FPGA-Computer/Soapbox-Racer/README.md

Soapbox-Racer
=============

This is the repository for the FPGA Computer "Soapbox Racer" PCB.

Schematic tool: Eagle CAD 6.5.0
3D modelling: Sketchup 14.1 2014

Licensing:
Due to the different ownership of the contributed files, the licensing
is complicated.  Please read the license.txt and additional copyright
notices in the individual files.

Schematic is distributed with Creative Commons 4.0 Attribution-NonCommercial
Layout artwork: (C) Copyrights 2014 all reserved by K. C. Lee
3D modelling: Creative Commons 4.0 Attribution-NonCommercial-NoDerivs International

Firmware/FPGA core: mixed based on the copyrights of the original
owners. Please read the individual files.  I'll try to make my code compatible to 
the contributed source code whenever possible.

Creative Commons 4.0 Attribution-NonCommercial:
See http://creativecommons.org/licenses/by-nc/4.0/

Creative Commons 4.0 Attribution-NonCommercial-NoDerivatives International
See http://creativecommons.org/licenses/by-nc-nd/4.0/
