FPGA-Computer/Soapbox-Racer/Hardware/Rev 0/Defect list/Defect 1.pdf

[Edit project log - Delete project log]

This is a project log entry for FPGA Computer/Eval board

# Defect list

I guess I should start maintaining a defect list:

Library: | con-usb-2.lbr by Erik Christiansson; | also | con-usb-3.lbr by same
author

Level: Serious, require localized copper change

Problem has not been resolved in con-usb-3.lbr at Cadsoft ftp.

Acon UAR80-4* datasheet clearly shown pin 1 location (USB Bus Power), but instead it is connected to ground. Seems like all the pin numbering is wrong, so all pins are affected.

Foorprint:

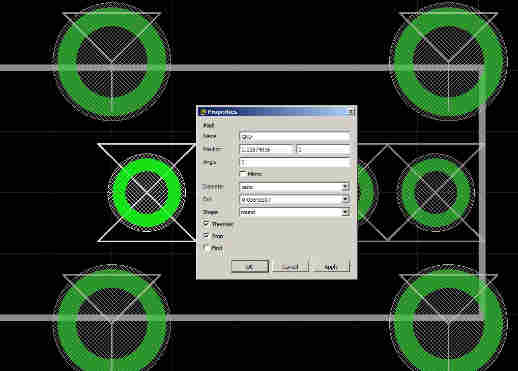
[picture p1: figure]

USB 2.0 standard:

Projects | Hackers | Blog | Search | Add a Project
More | Feed

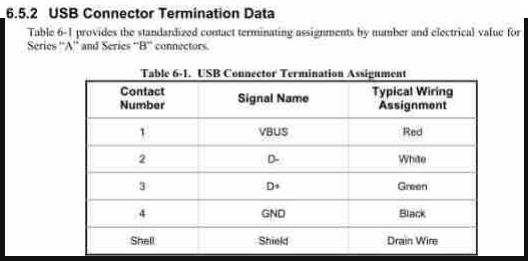
[picture p2: figure]
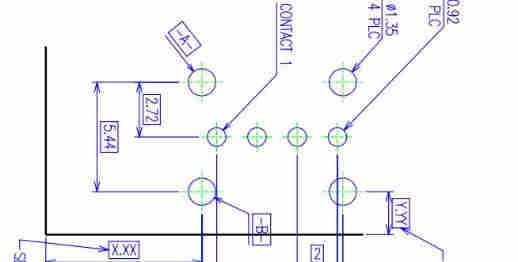
[picture p3: figure]
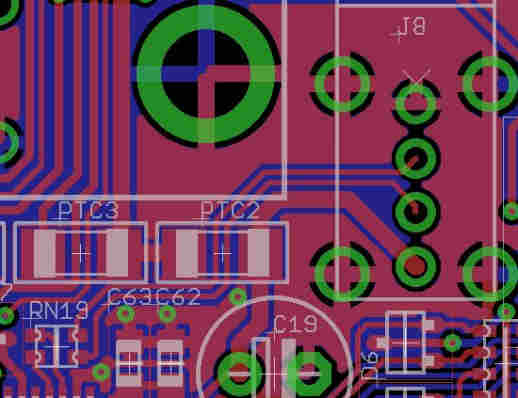
[picture p4: figure]

DISCUSSIONS

Add your comment

ACON Connector datasheet

Short term fix:

From a mechanical strength/appearance point of view, I should keep the
connector as is, | USB signals | are best reversed | at RN19 to preserve the
routing. Power/ground can be reverse | by cutting trace and thermals next to
connector pin and | jumper by magnetic | wire.
