FPGA-Computer/Soapbox-Racer/Hardware/Rev 0/FPGA Computer Rev15 Rel 0 (no fills).pdf

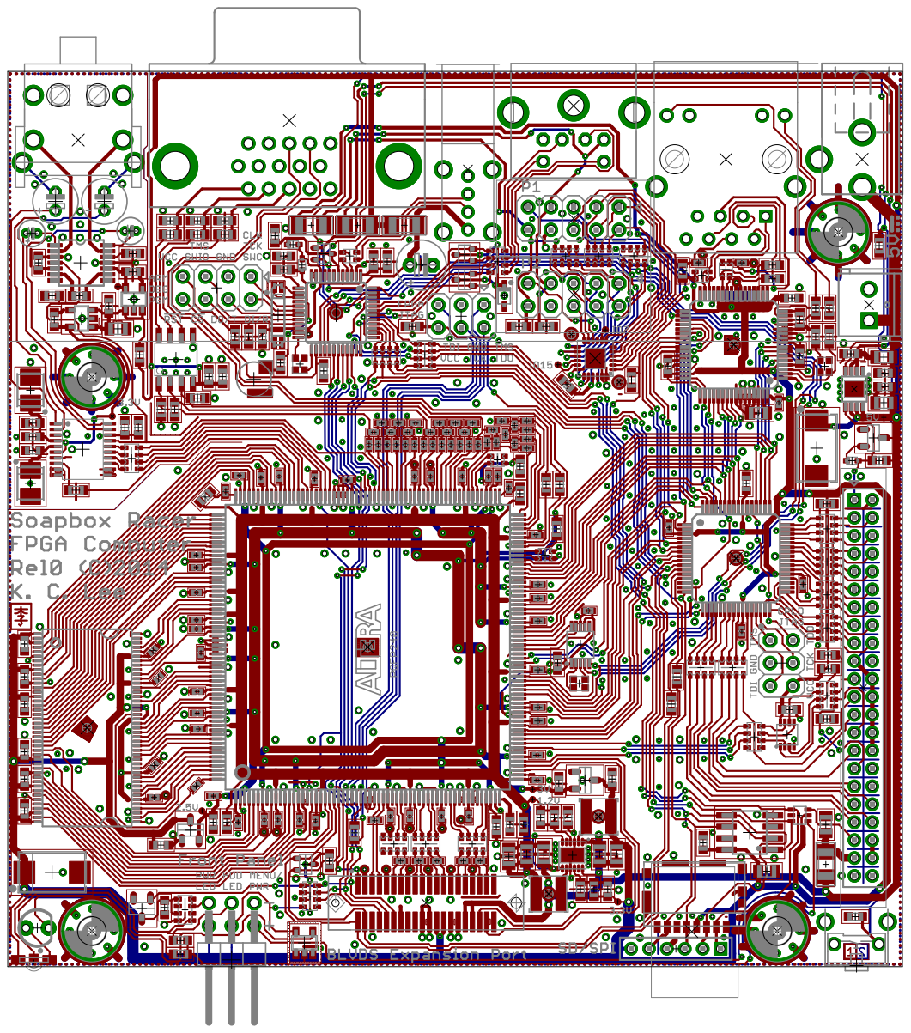
[picture p5: page 1]
