FPGA-Computer/Soapbox-Racer/Hardware/Rev 0/FPGA Computer Rev15 Rel 0 (plane fills).pdf

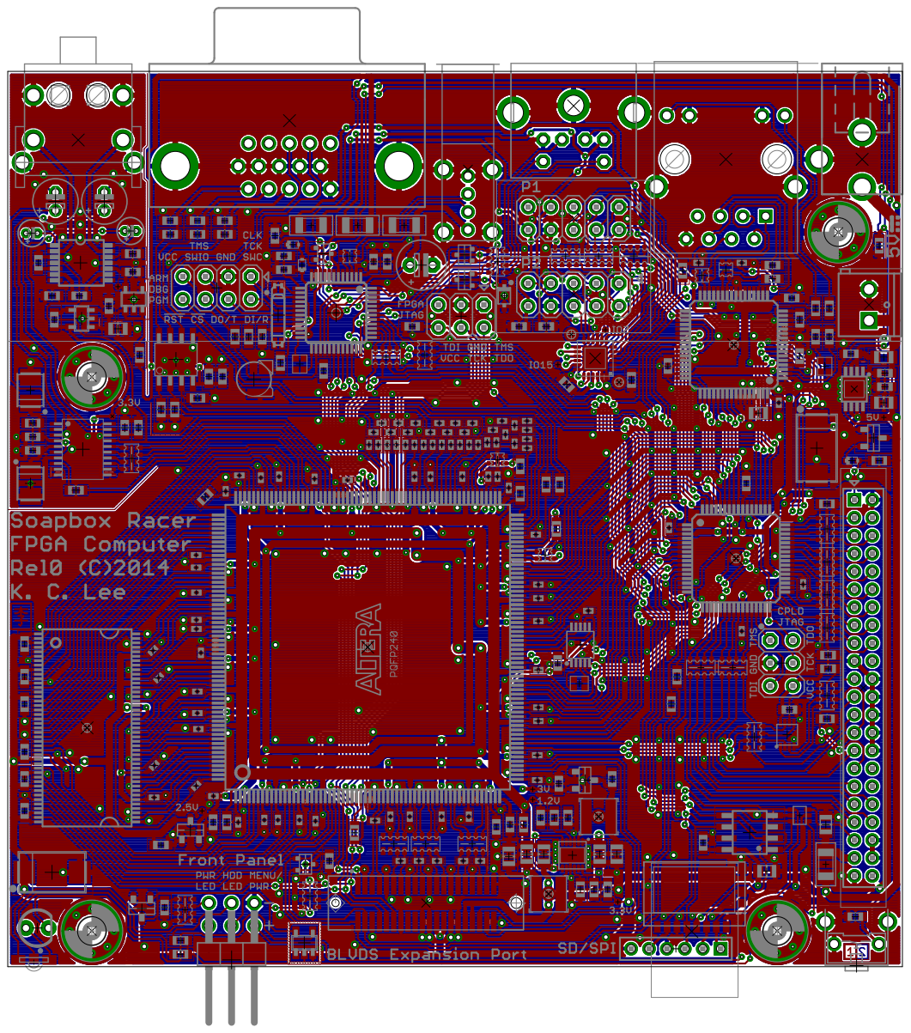
[picture p6: page 1]
