FPGA-Computer/Soapbox-Racer/Hardware/Rev 0/FPGA Computer Rev15 Rel 0.pdf

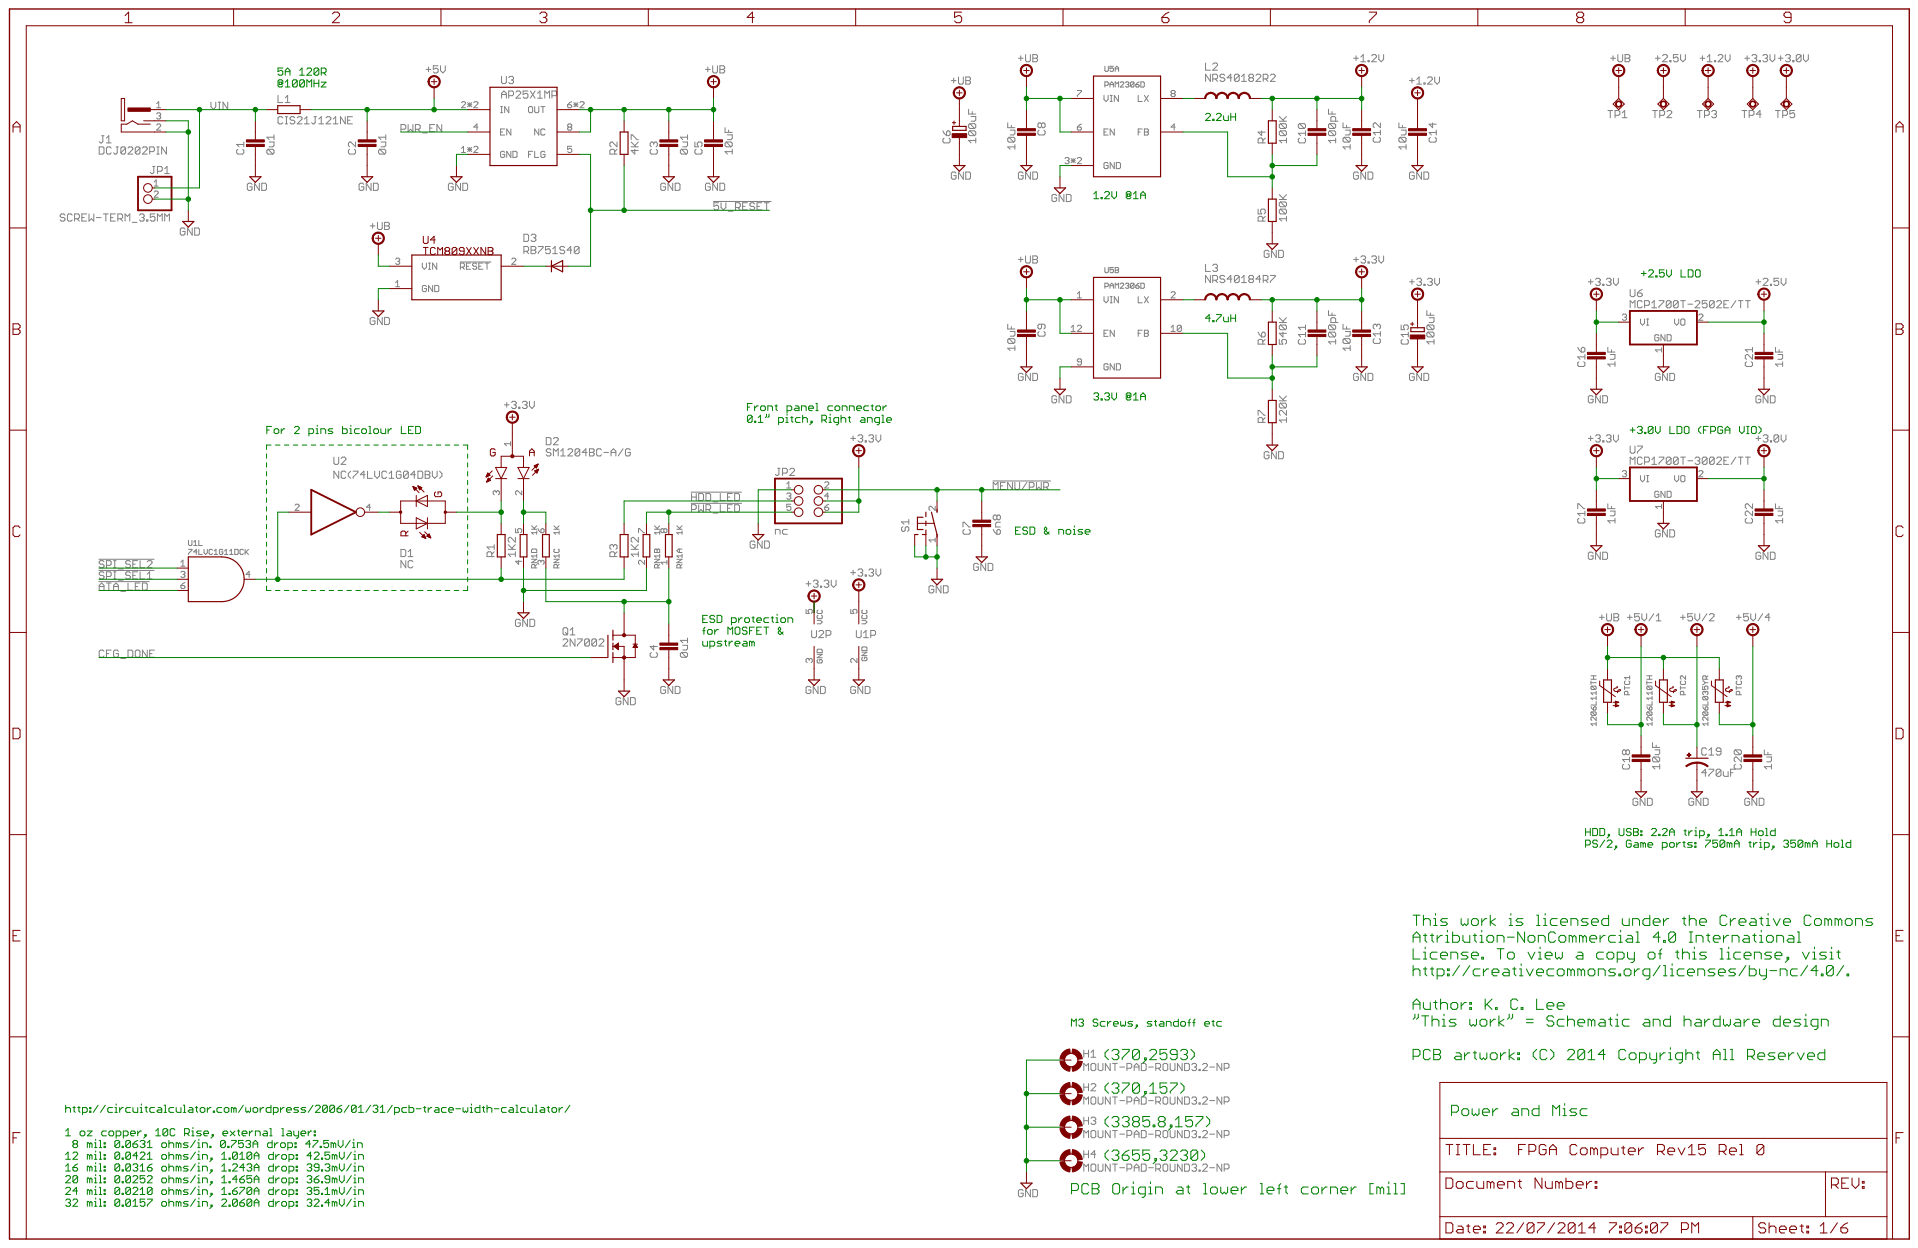
[picture p7: page 1]

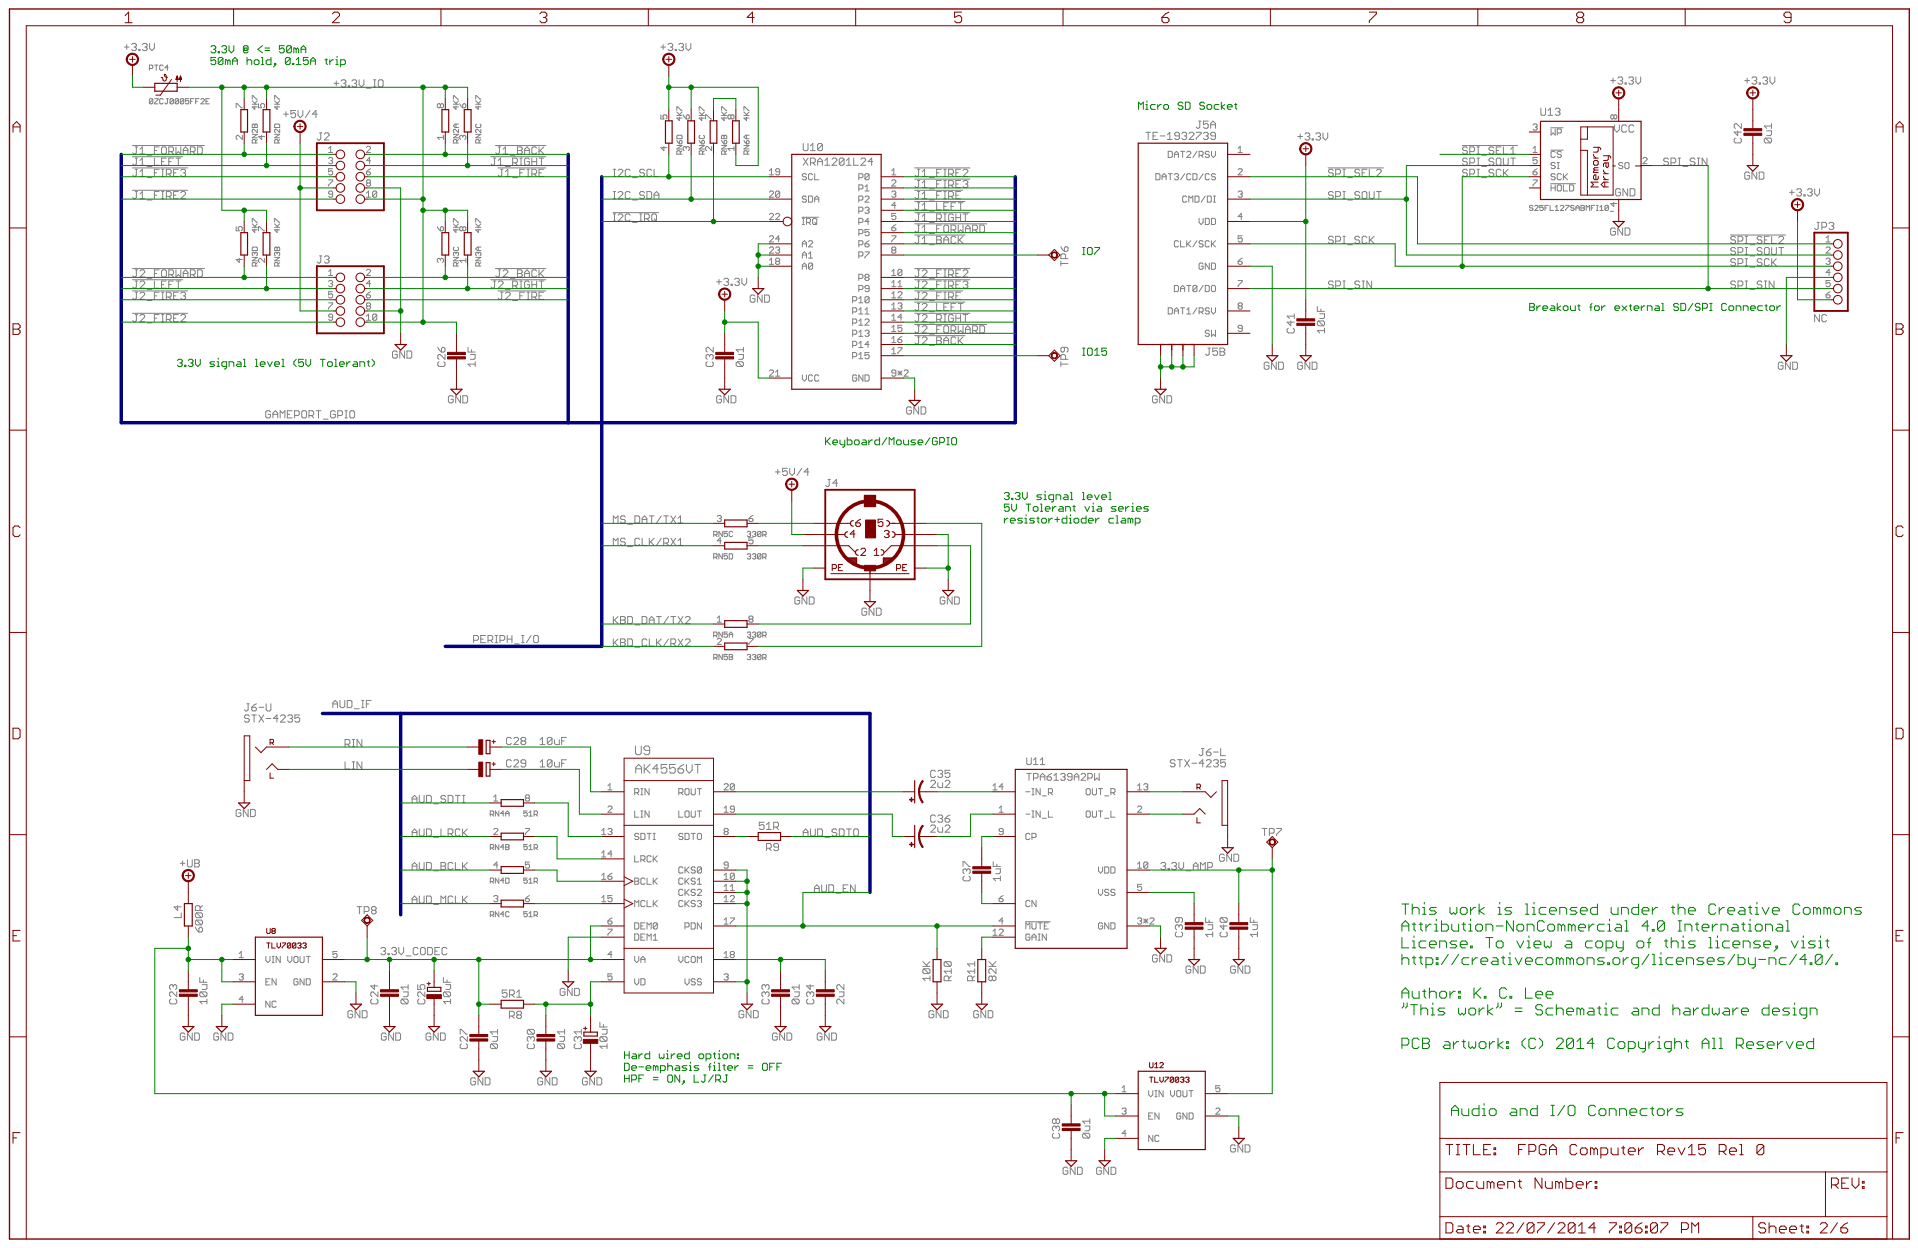
[picture p8: page 2]

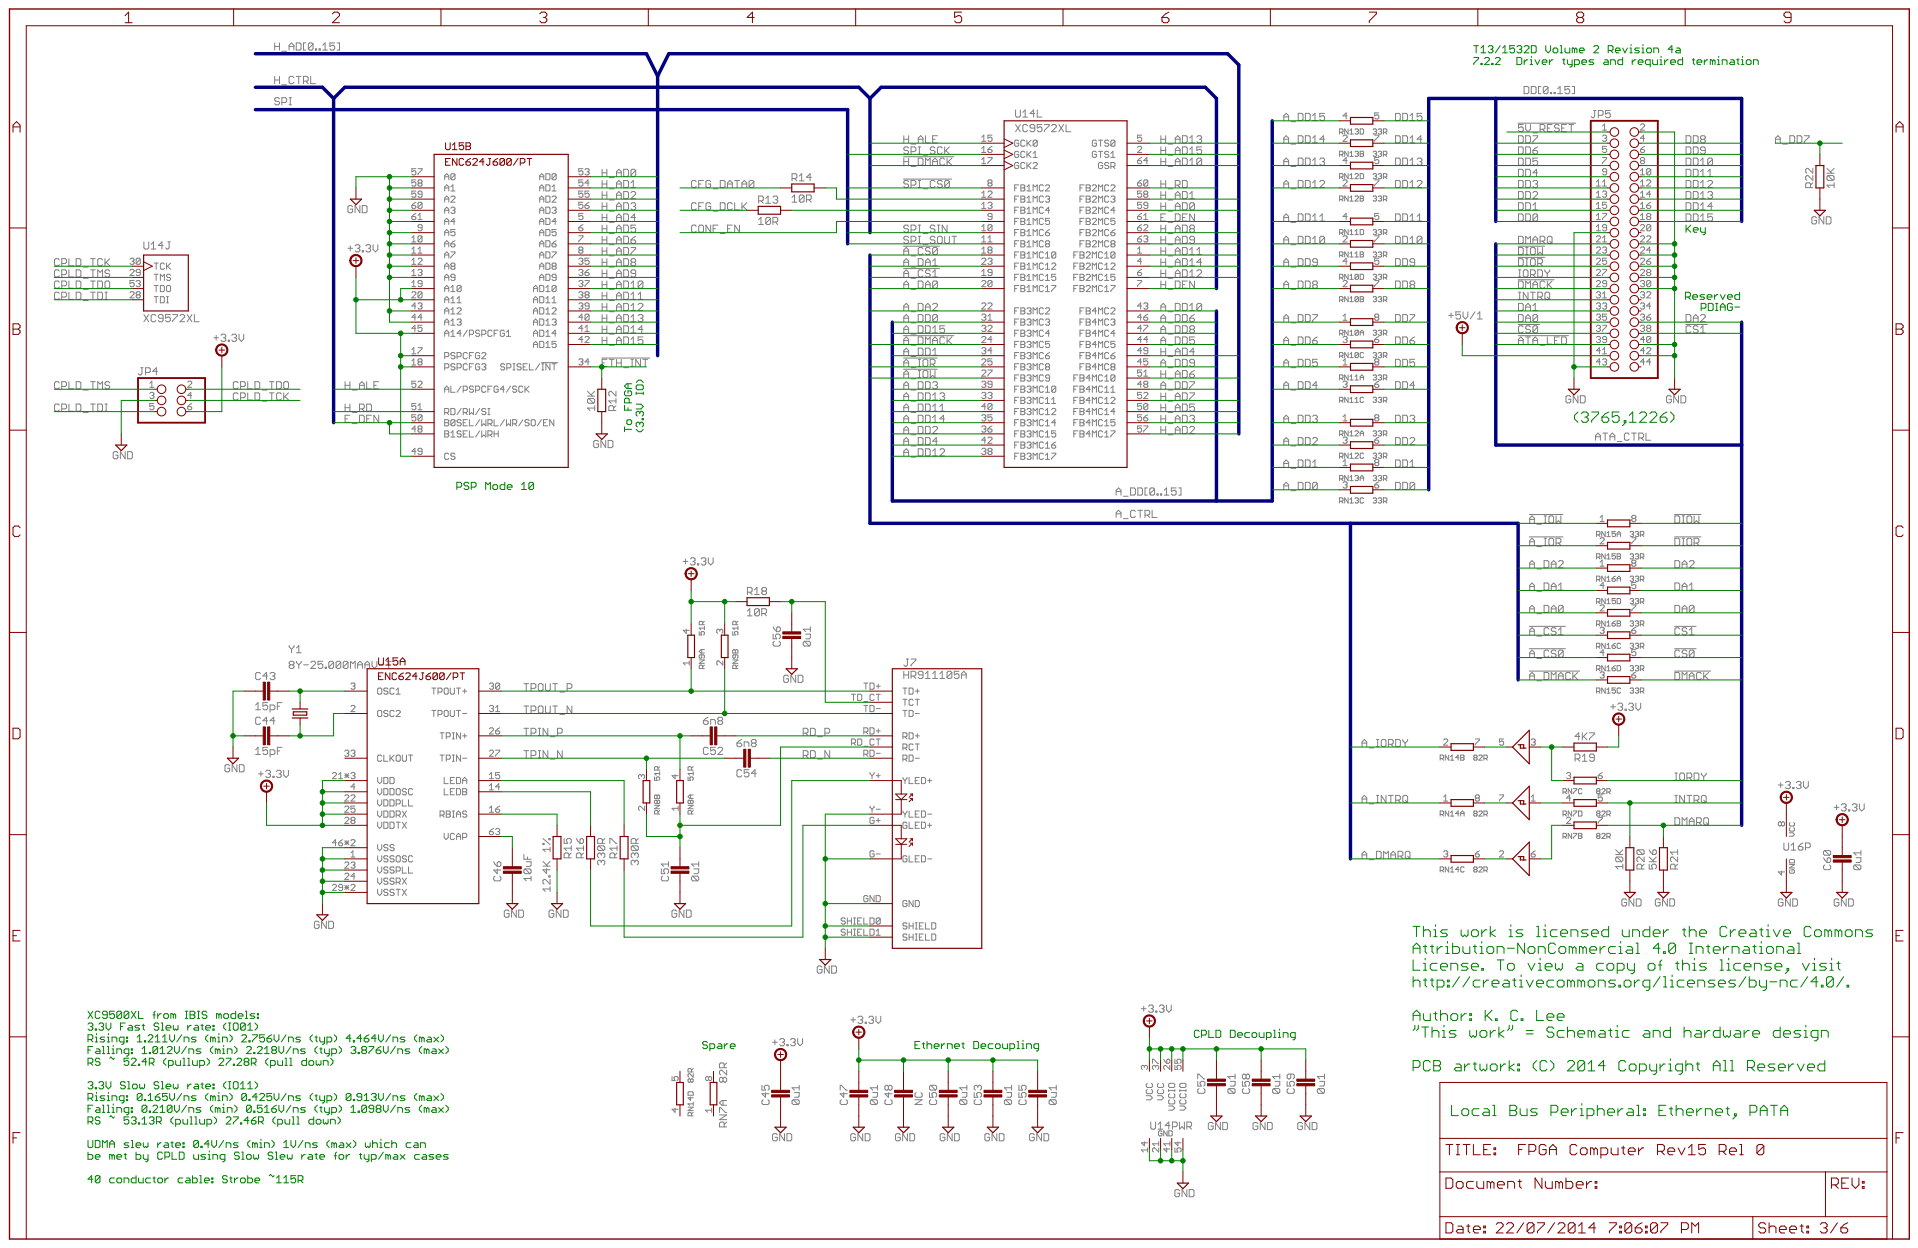
[picture p9: page 3]

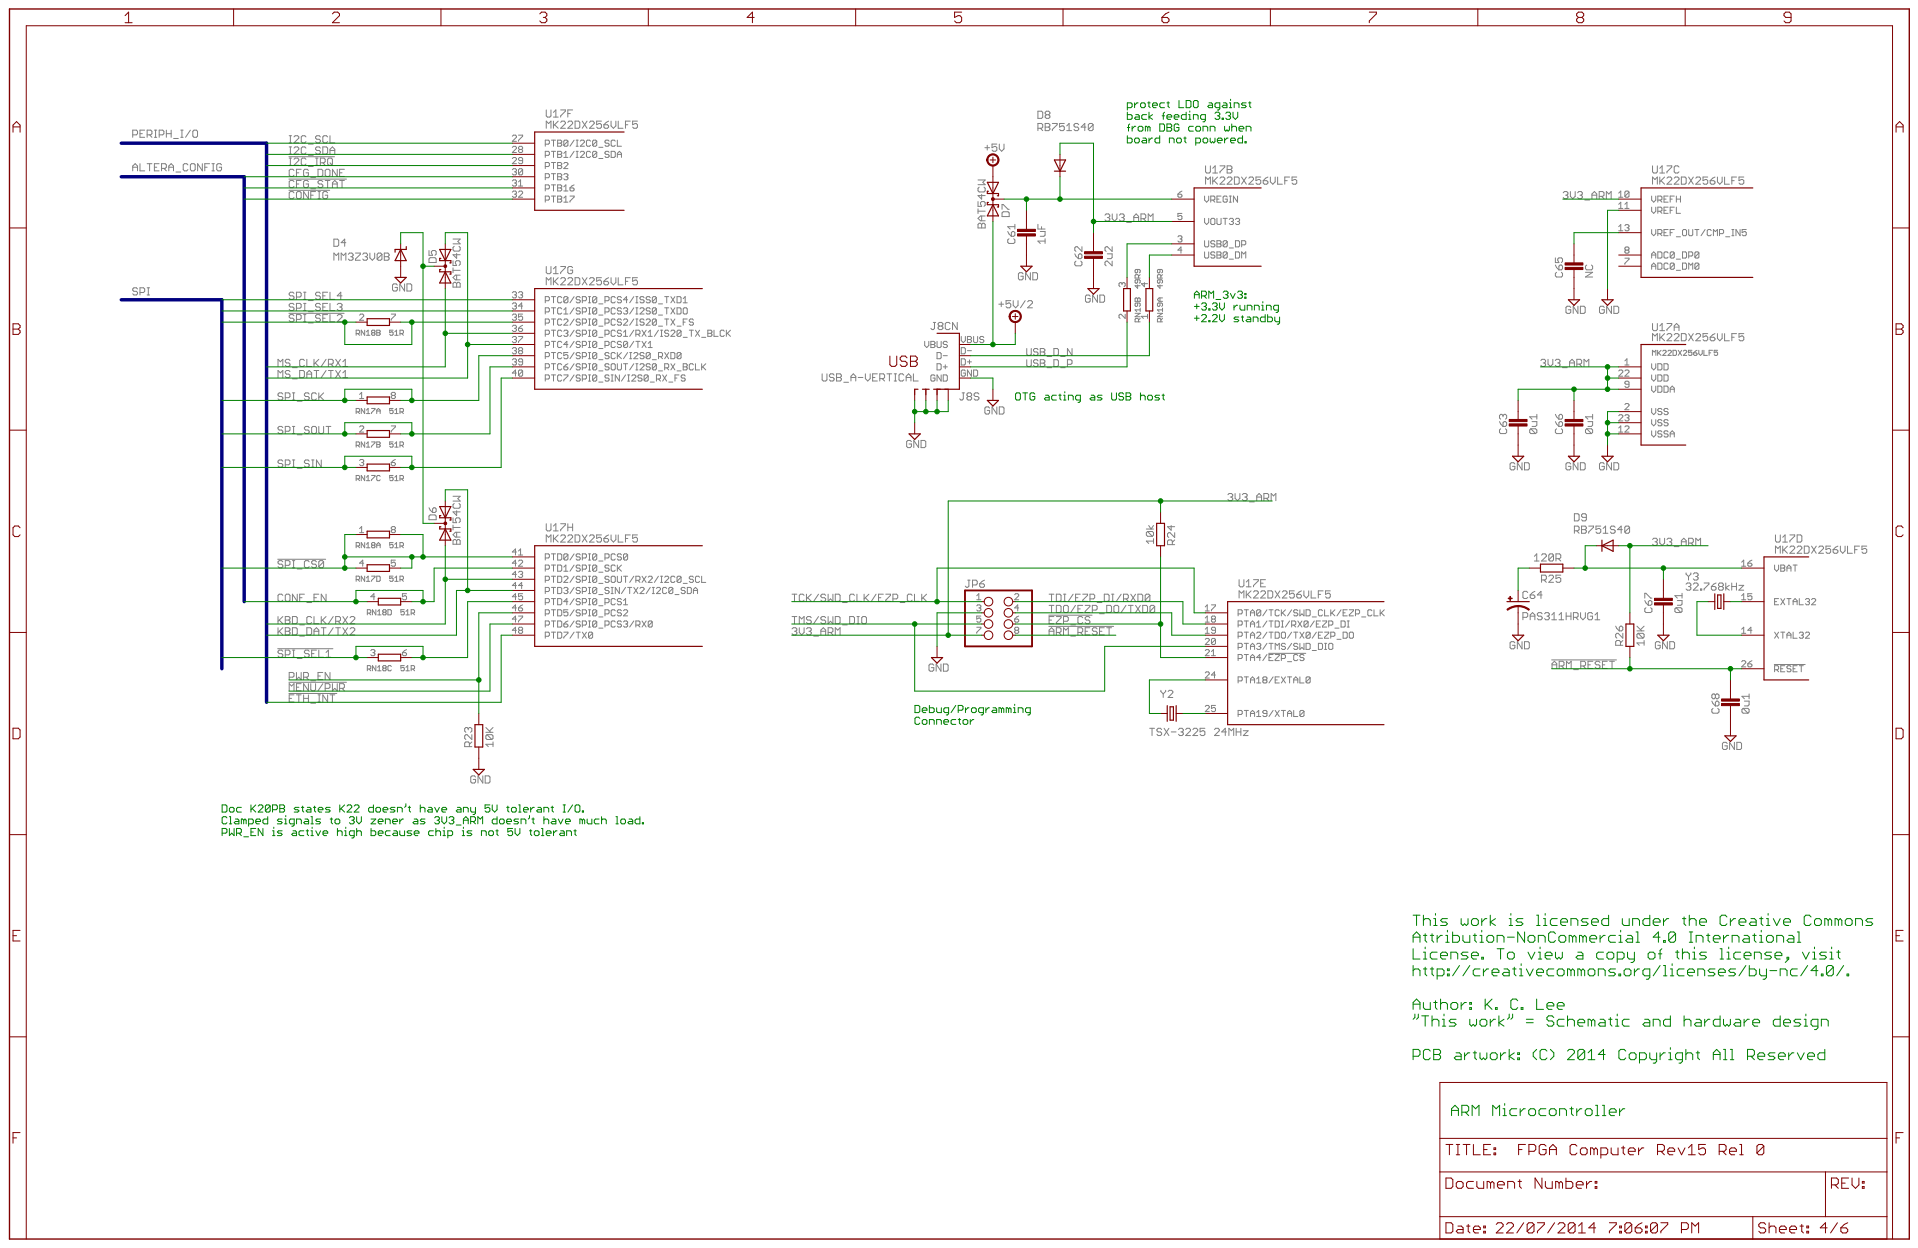
[picture p10: page 4]

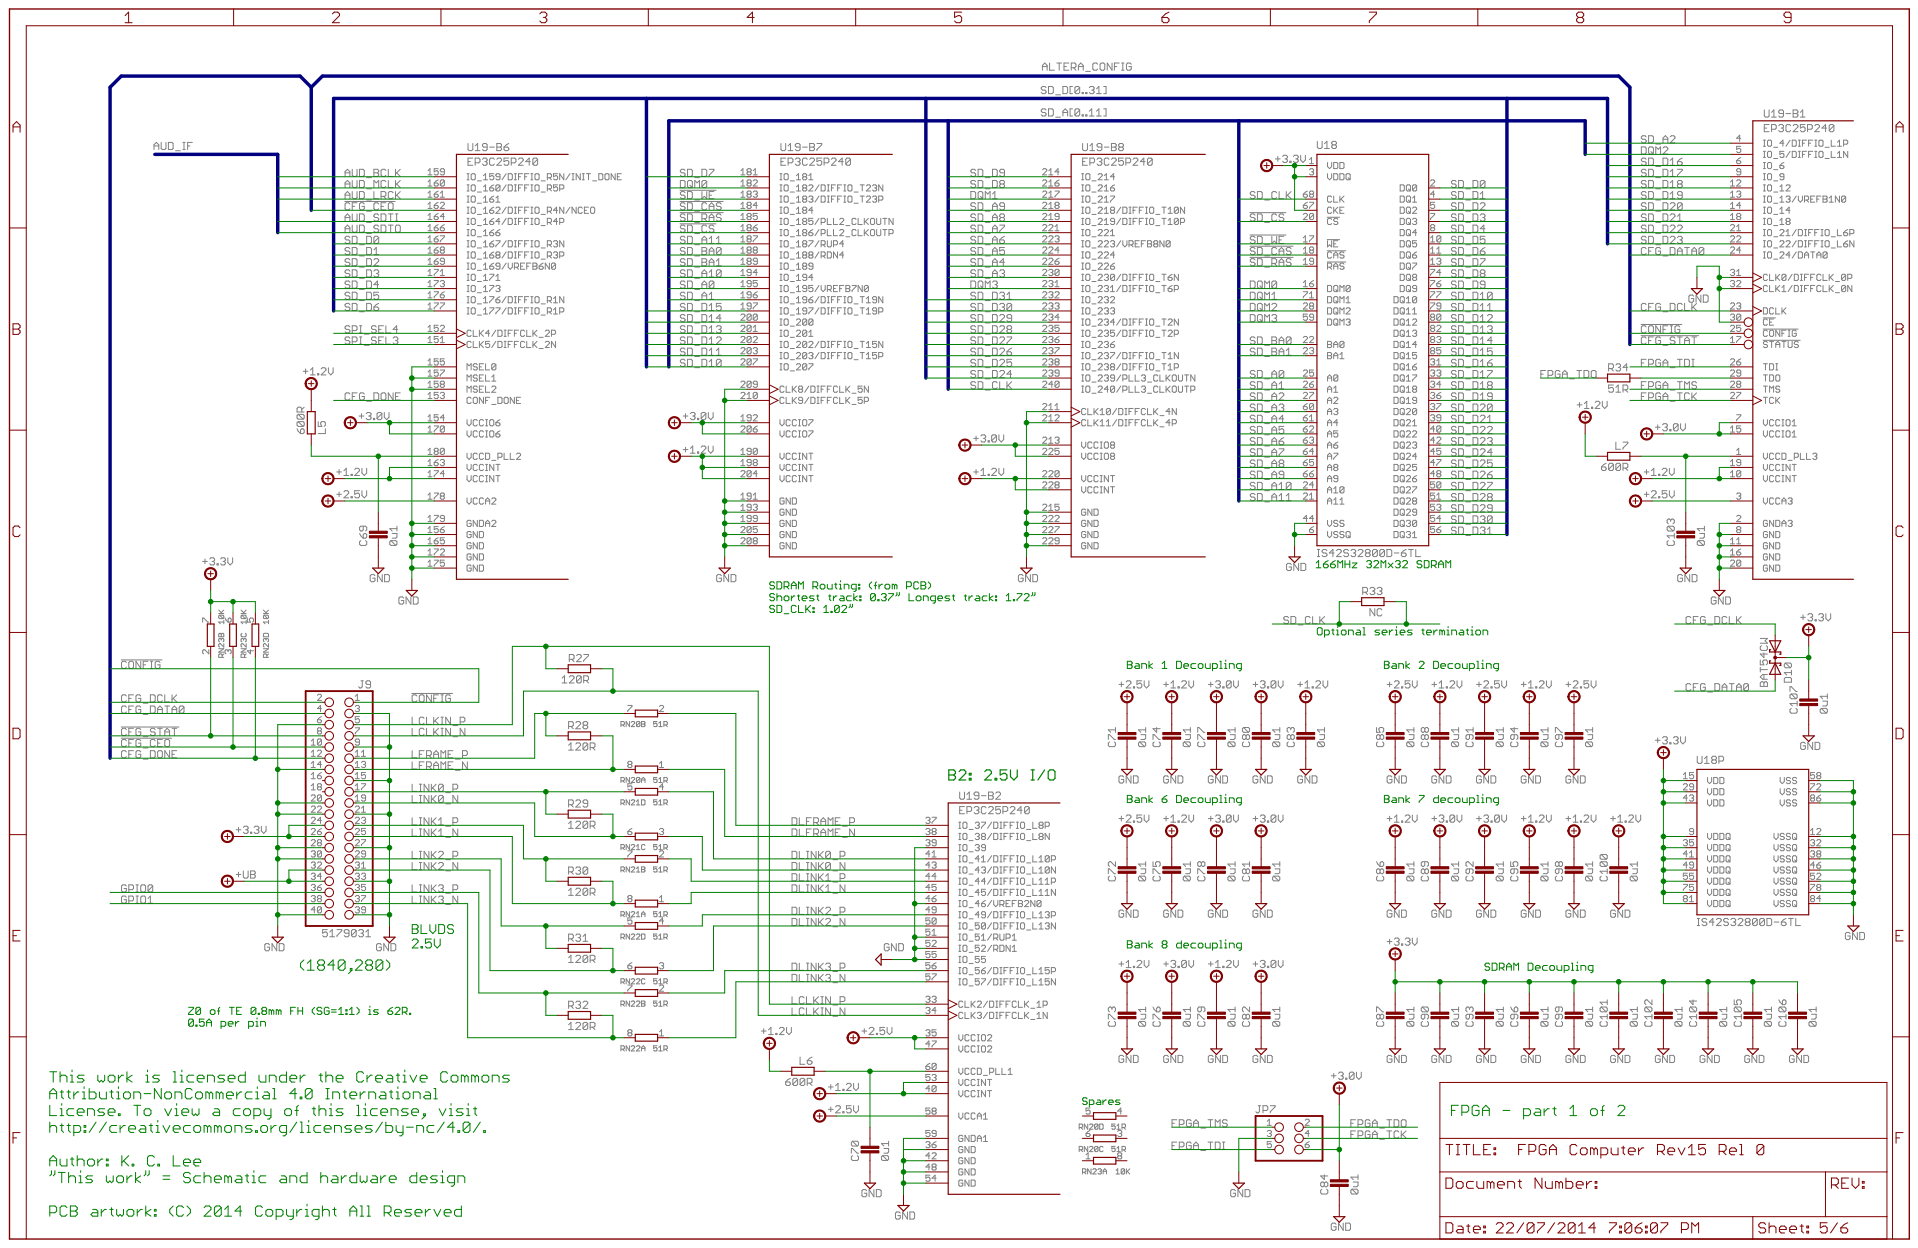
[picture p11: page 5]

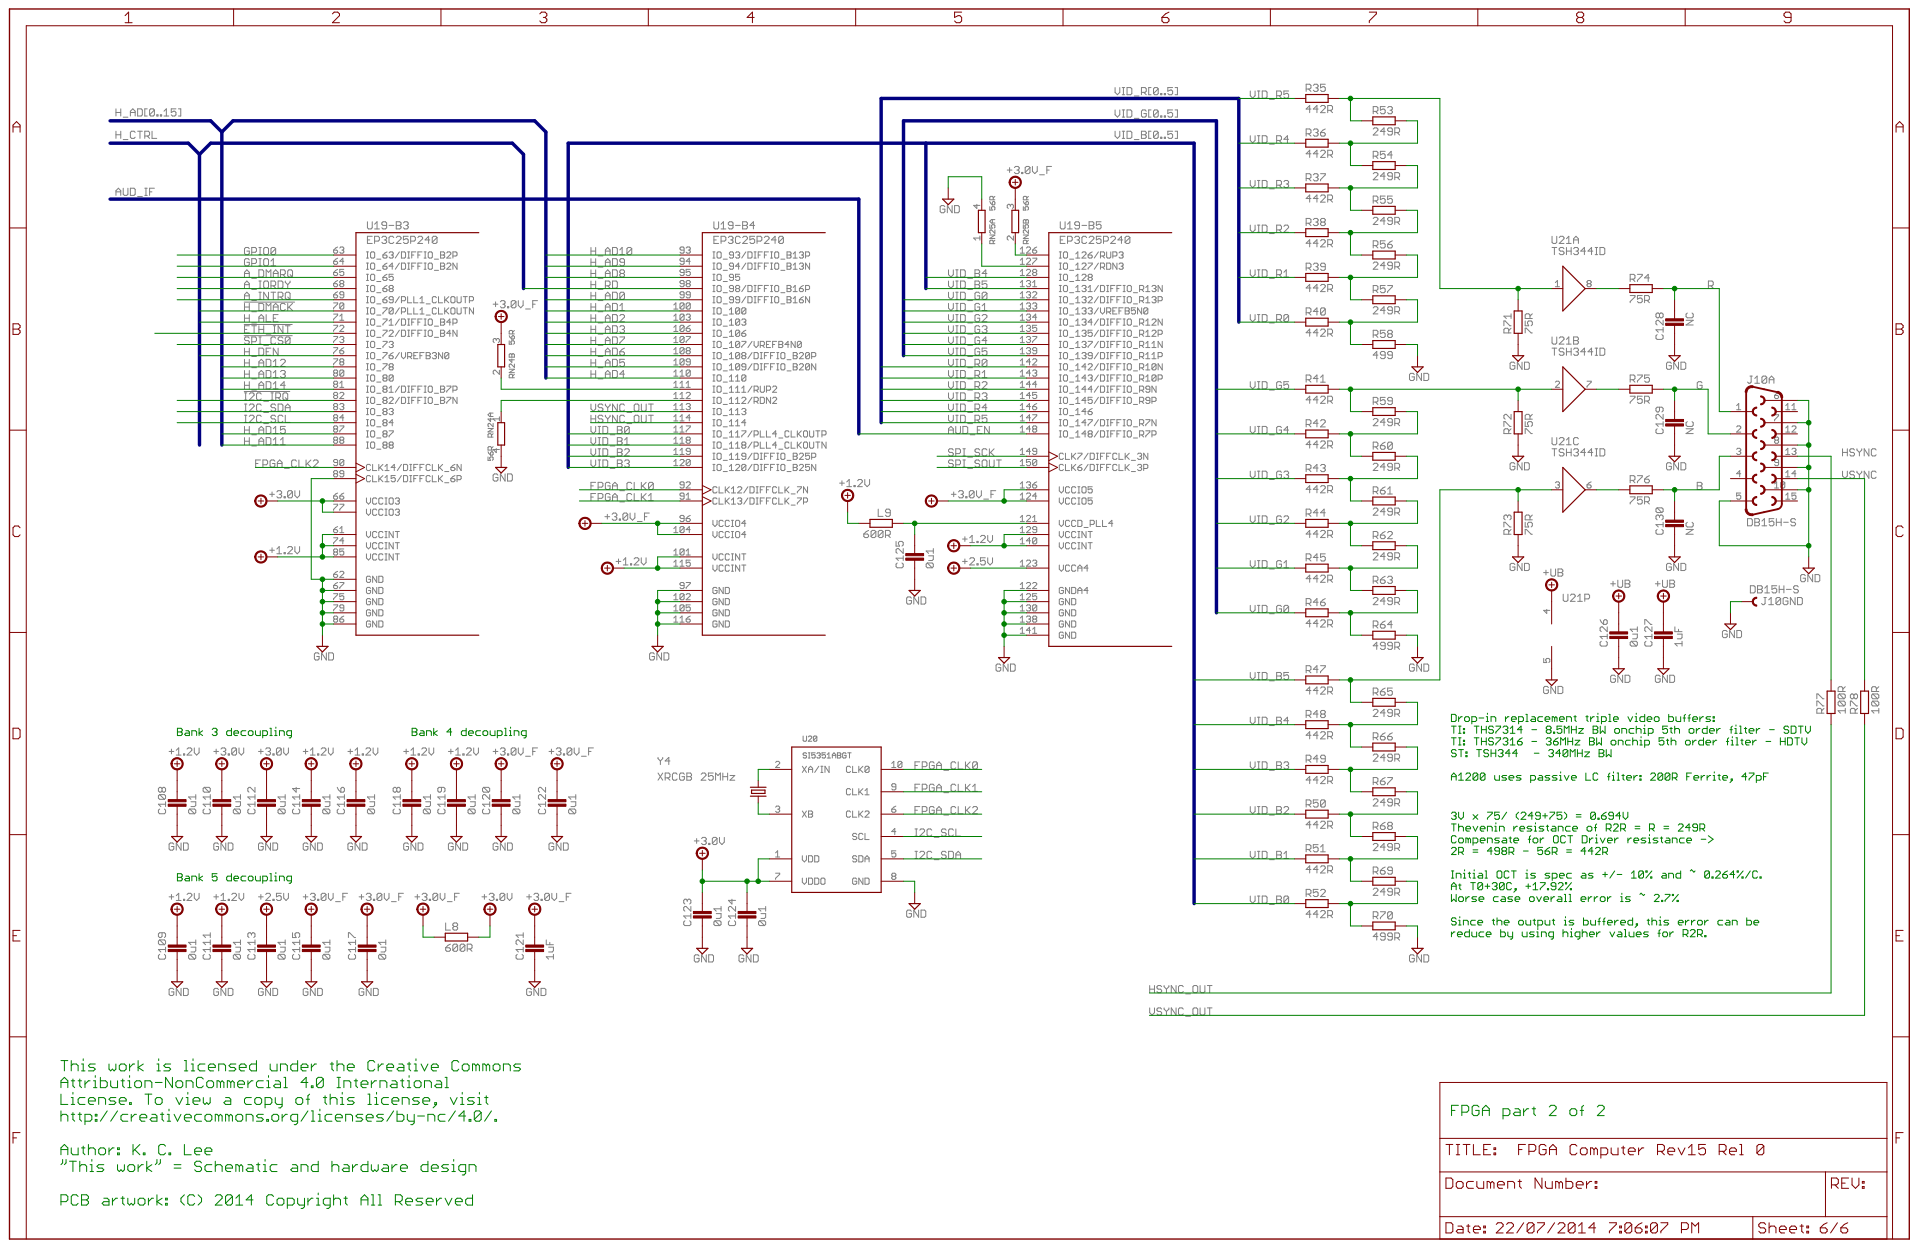
[picture p12: page 6]
