FPGA-Computer/Soapbox-Racer/Firmware/FatFS Demo/fattime.h

#ifndef FATTIME_H_
#define FATTIME_H_

#define FAT_BASE_YEAR           1980
#define FATTIME_SECONDS_MASK    0x001F
#define FATTIME_MINUTES_MASK    0x07E0
#define FATTIME_HOURS_MASK      0xF800
#define FATTIME_DAYS_MASK       0x001F
#define FATTIME_MONTHS_MASK     0x01E0
#define FATTIME_YEARS_MASK      0xFE00

#endif
