FPGA-Computer/Soapbox-Racer/(commit log)

2014-08-07 Proto PCB rev init commit
    [Digikey parts for Rel 0.csv]
2014-09-25 Fix compiler macro, add board.h
    [board.c, board.h]
2014-09-25 change DMA Dummy Size to 16-bit!
2014-09-25 change DMA Dummy init to 16-bit!
