FPGA-Computer/Soapbox-Racer/(notices)

Notices in the files:
Firmware/my version of os files/rtc.c:
under the terms of the GNU General Public License as published by the
Free Software Foundation; either version 2, or (at your option) any
